kevin-nguyen-dev/stm32-dev-board-hw/stm32-dev-board-hw/models/SMLVT3V3.stp

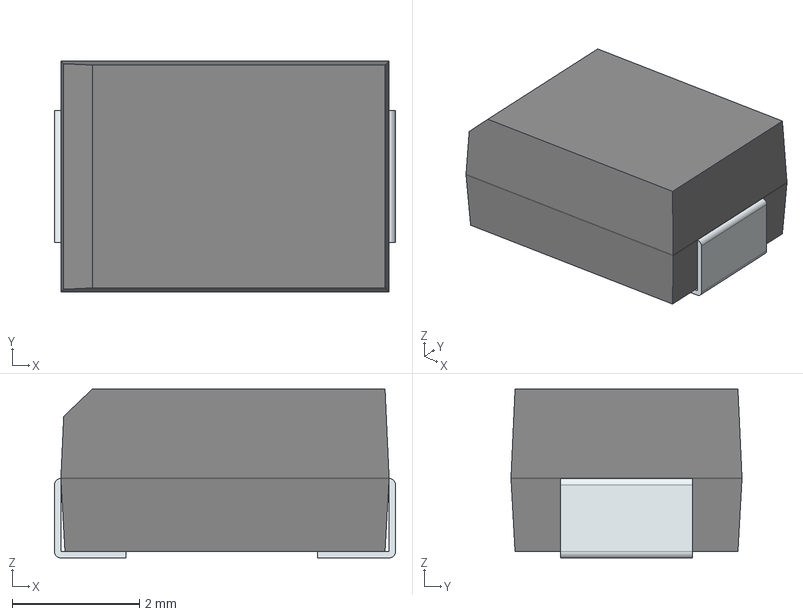
[picture p1: CAD file, 2024-08-15]
stm32-dev-board-hw/models/SMLVT3V3.stp
5.35 x 3.62 x 2.65 mm
FilletPin1
FilletPin2
