kevin-nguyen-dev/stm32-dev-board-hw/stm32-dev-board-hw/models/NX2016SA-32M-EXS00A-CS06465.stp

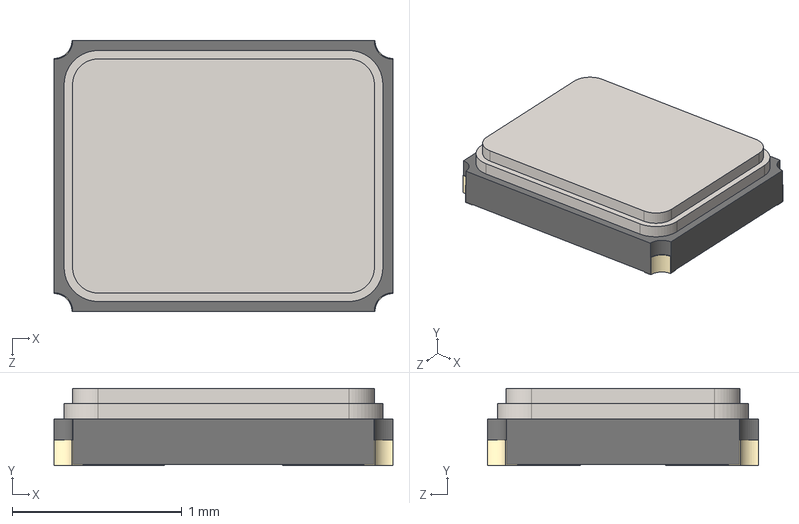
[picture p2: CAD file, 2024-08-15]
stm32-dev-board-hw/models/NX2016SA-32M-EXS00A-CS06465.stp
2.00 x 0.455 x 1.60 mm
