kevin-nguyen-dev/stm32-dev-board-hw/stm32-dev-board-hw/models/ANT1608LL14R2400A.stp

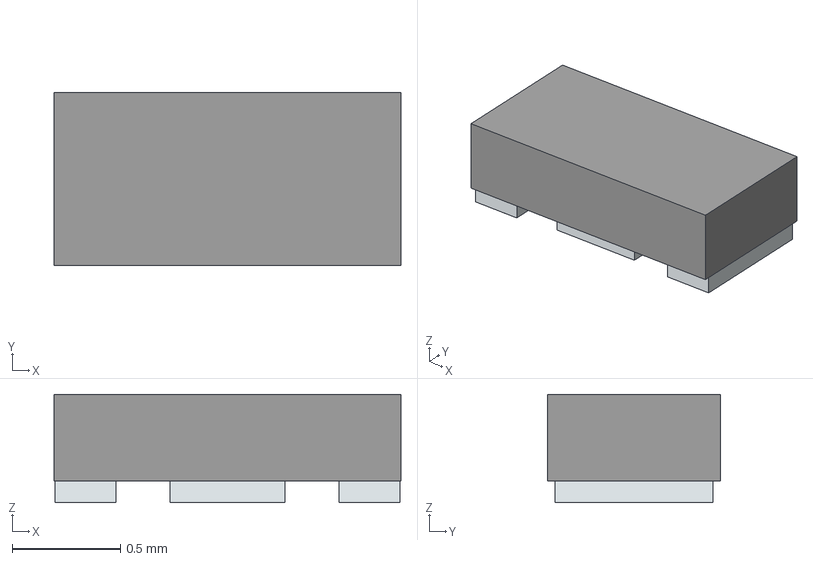
[picture p3: CAD file, 2024-08-15]
stm32-dev-board-hw/models/ANT1608LL14R2400A.stp
1.60 x 0.8 x 0.5 mm
Pins
