kevin-nguyen-dev/stm32-dev-board-hw/stm32-dev-board-hw/models/STM32WB55CEU6.stp

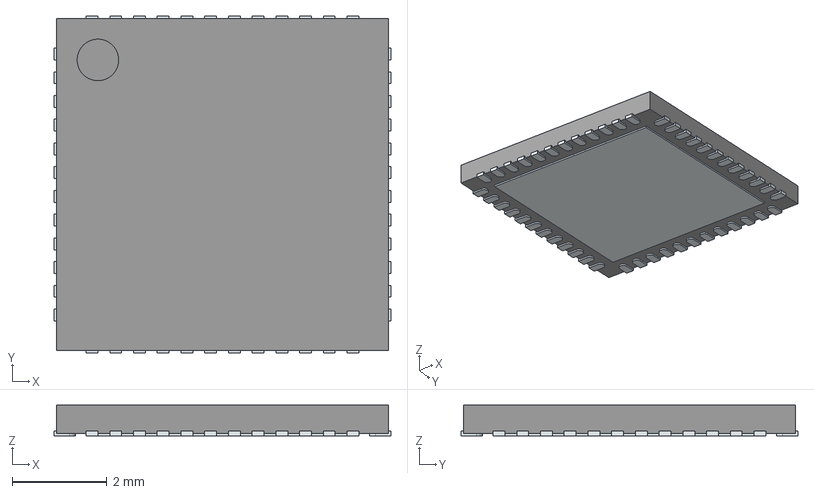
[picture p4: CAD file, 2024-08-15]
stm32-dev-board-hw/models/STM32WB55CEU6.stp
7.10 x 7.10 x 0.65 mm
ThermalPin
PinsArrayLR
PinsArrayTB
