kevin-nguyen-dev/stm32-dev-board-hw/stm32-dev-board-hw/models/DLF162500LT-5028A1.stp

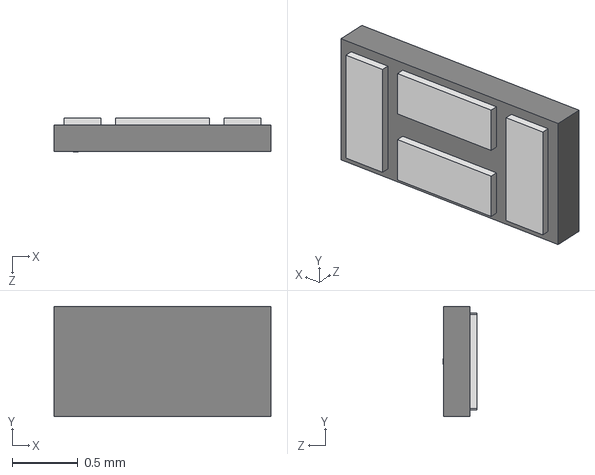
[picture p5: CAD file, 2024-08-15]
stm32-dev-board-hw/models/DLF162500LT-5028A1.stp
1.65 x 0.838 x 0.257 mm
