kevin-nguyen-dev/stm32-dev-board-hw/stm32-dev-board-hw/kicad-proj/stm32-dev-board/stm32-dev-board.kicad_pcb

## KiCad design stm32-dev-board-hw/kicad-proj/stm32-dev-board/stm32-dev-board.kicad_pcb (2024-08-15)

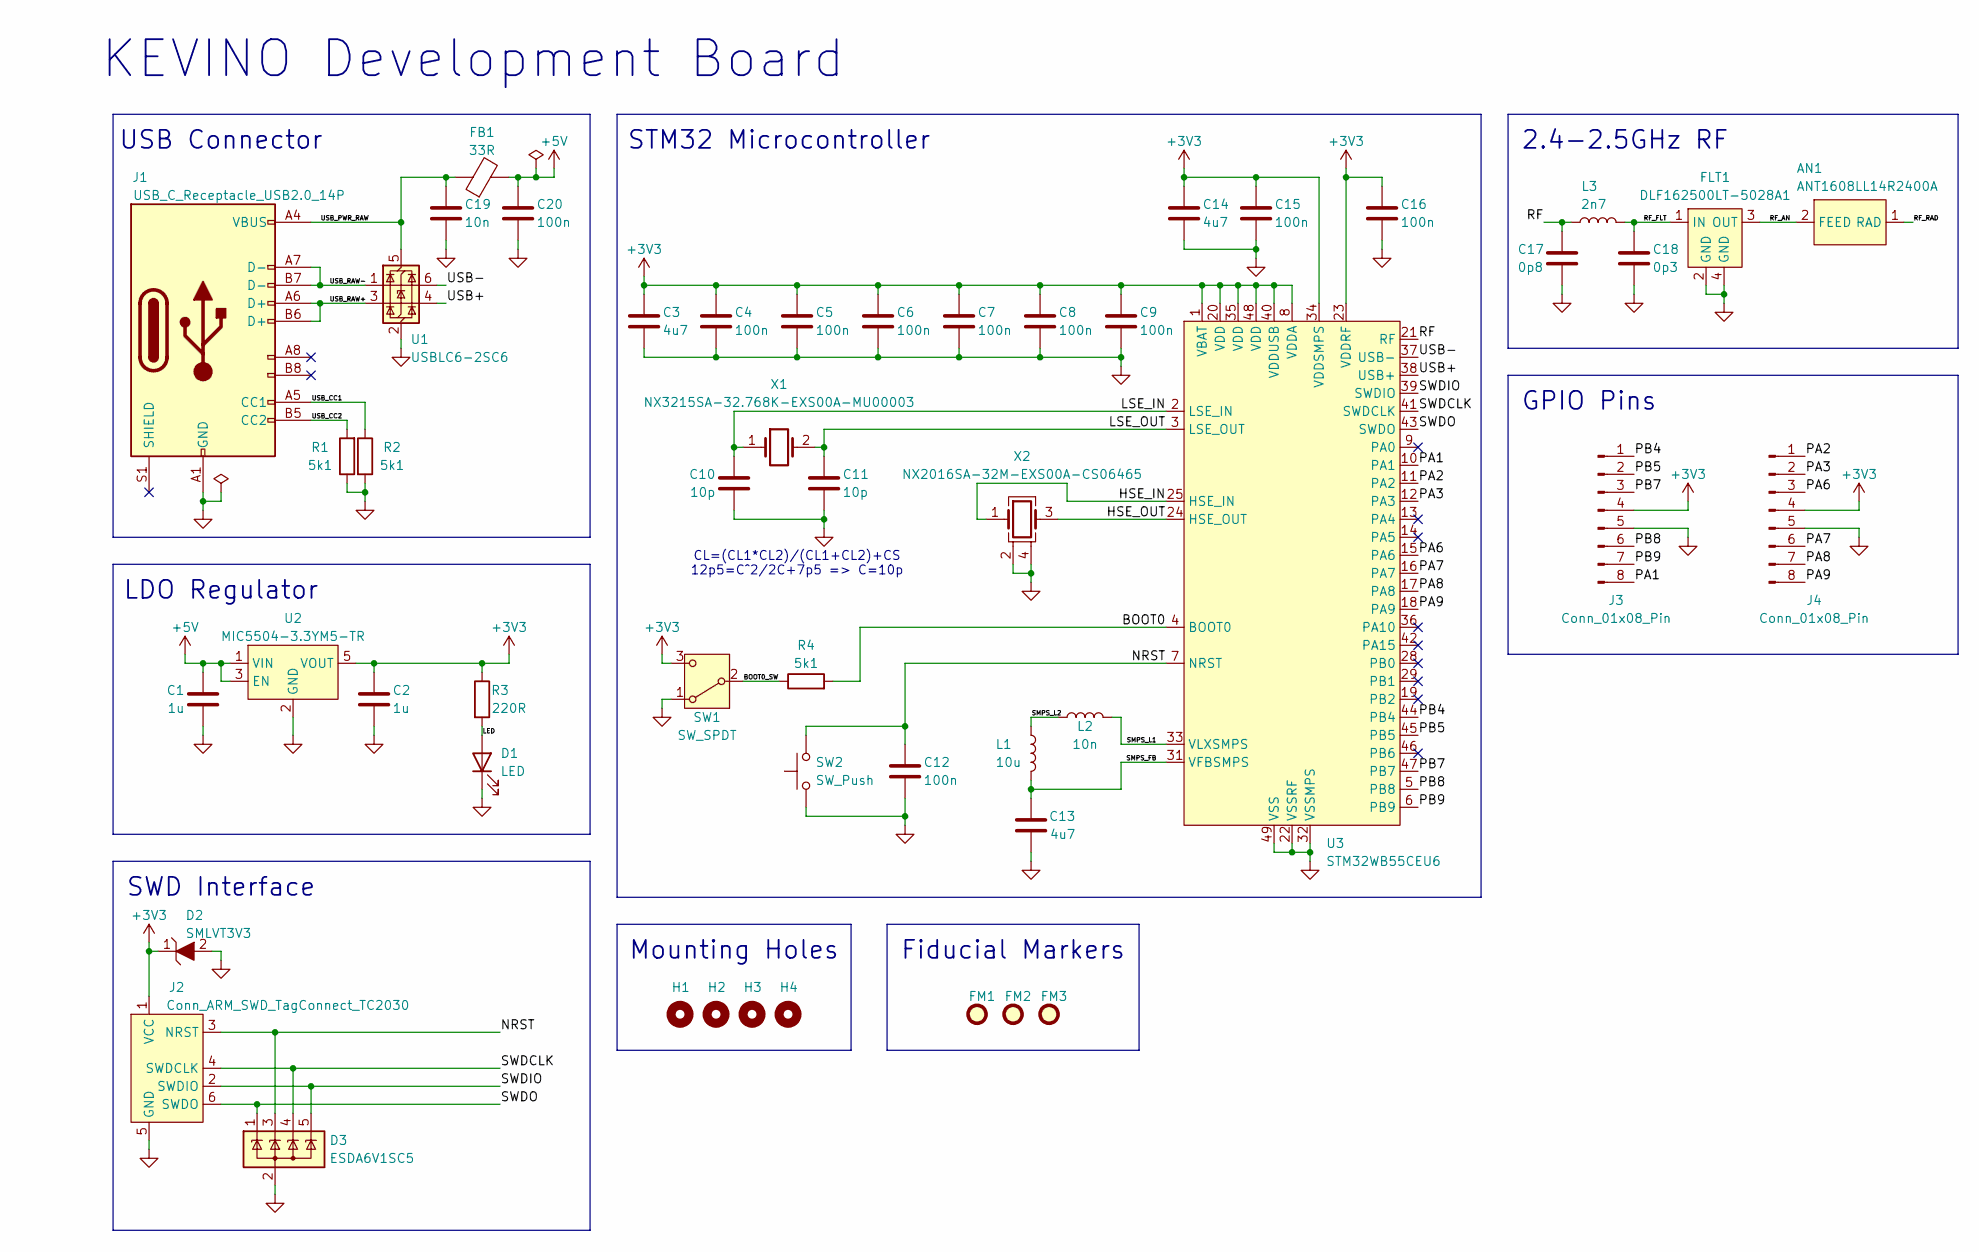
[picture p6: schematic stm32-dev-board.kicad_sch, KEVINO]

Parts:
AN1: ANT1608LL14R2400A; Manufacturer Part Number ANT1608LL14R2400A
C1, C2: 1u; C_0603_1608Metric; Manufacturer Part Number 0603ZD105KAT2A
C3, C13, C14: 4u7; C_0603_1608Metric; Manufacturer Part Number 0603YD475MAT2A
C4, C5, C6, C7, C8, C9, C12, C15, C16, C20: 100n; C_0402_1005Metric; Manufacturer Part Number 04023C104KAT2A
C10, C11: 10p; C_0402_1005Metric; Manufacturer Part Number 04025A100JAT2A
C17: 0p8; C_0402_1005Metric; Manufacturer Part Number GRM1555C1HR80BA01D
C18: 0p3; C_0402_1005Metric; Manufacturer Part Number GRM1555C1HR30WA01D
C19: 10n; C_0201_0603Metric; Manufacturer Part Number 0201ZC103JAT2A
D1: LED; LED_0402_1005Metric; Manufacturer Part Number 150040RS73240
D2: SMLVT3V3; Manufacturer Part Number SMLVT3V3
D3: ESDA6V1SC5; SOT-23-5; Manufacturer Part Number ESDA6V1SC5
FB1: 33R; R_0603_1608Metric; Manufacturer Part Number BLM18PG330SN1D
FLT1: DLF162500LT-5028A1; Manufacturer Part Number DLF162500LT-5028A1
FM1, FM2, FM3: Fiducial; Fiducial_1mm_Mask2mm
H1, H2, H3, H4: MountingHole; MountingHole_2.2mm_M2_DIN965_Pad
J1: USB_C_Receptacle_USB2.0_14P; USB_C_Receptacle_GCT_USB4105-xx-A_16P_TopMnt_Horizontal; Manufacturer Part Number USB4105-GF-A
J2: Conn_ARM_SWD_TagConnect_TC2030; Tag-Connect_TC2030-IDC-FP_2x03_P1.27mm_Vertical
J3, J4: Conn_01x08_Pin; PinHeader_1x08_P2.54mm_Vertical; Manufacturer Part Number 22-28-8082
L1: 10u; L_0805_2012Metric; Manufacturer Part Number LQM21FN100M70L
L2: 10n; L_0402_1005Metric; Manufacturer Part Number LQG15WZ10NJ02D
L3: 2n7; L_0402_1005Metric; Manufacturer Part Number LQG15HS2N7S02D
R1, R2, R4: 5k1; R_0402_1005Metric; Manufacturer Part Number RC0603FR-075K1L
R3: 220R; R_0402_1005Metric; Manufacturer Part Number RC0402FR-07221RL
SW1: SW_SPDT; SW_SPDT_PCM12; Manufacturer Part Number PCM12SMTR
SW2: SW_Push; SW_SPST_CK_RS282G05A3; Manufacturer Part Number RS282G05A3SMRT
U1: USBLC6-2SC6; SOT-23-6; Manufacturer Part Number USBLC6-2SC6
U2: MIC5504-3.3YM5-TR; SOT-23-5; Manufacturer Part Number MIC5504-3.3YM5-TR
U3: STM32WB55CEU6; Manufacturer Part Number STM32WB55CEU6
X1: NX3215SA-32.768K-EXS00A-MU00003; Crystal_SMD_MicroCrystal_CC7V-T1A-2Pin_3.2x1.5mm; Manufacturer Part Number NX3215SA-32.768K-EXS00A-MU00003
X2: NX2016SA-32M-EXS00A-CS06465; Crystal_SMD_2016-4Pin_2.0x1.6mm; Manufacturer Part Number NX2016SA-32M-EXS00A-CS06465

Connections:
+3V3: C2.1, C3.1, C4.1, C5.1, C6.1, C7.1, C8.1, C9.1, C14.1, C15.1, C16.1, D2.1, J2.1 (VCC), J3.4, J4.4, R3.1, SW1.3 (C), U2.5 (VOUT), U3.1 (VBAT), U3.8 (VDDA), U3.20 (VDD), U3.23 (VDDRF), U3.34 (VDDSMPS), U3.35 (VDD), U3.40 (VDDUSB), U3.48 (VDD)
+5V: C1.2, C20.1, FB1.2, U2.1 (VIN), U2.3 (EN)
/BOOT0: R4.2, U3.4 (BOOT0)
/BOOT0_SW: R4.1, SW1.2 (B)
/HSE_IN: U3.25 (HSE_IN), X2.1
/HSE_OUT: U3.24 (HSE_OUT), X2.3
/LED: D1.2 (A), R3.2
/LSE_IN: C10.2, U3.2 (LSE_IN), X1.1
/LSE_OUT: C11.1, U3.3 (LSE_OUT), X1.2
/NRST: C12.1, D3.3 (K), J2.3 (NRST), SW2.2, U3.7 (NRST)
/PA1: J3.8, U3.10 (PA1)
/PA2: J4.1, U3.11 (PA2)
/PA3: J4.2, U3.12 (PA3)
/PA6: J4.3, U3.15 (PA6)
/PA7: J4.6, U3.16 (PA7)
/PA8: J4.7, U3.17 (PA8)
/PA9: J4.8, U3.18 (PA9)
/PB4: J3.1, U3.44 (PB4)
/PB5: J3.2, U3.45 (PB5)
/PB7: J3.3, U3.47 (PB7)
/PB8: J3.6, U3.5 (PB8)
/PB9: J3.7, U3.6 (PB9)
/RF: C17.2, L3.1, U3.21 (RF)
/RF_AN: AN1.2 (FEED), FLT1.3 (OUT)
/RF_FLT: C18.1, FLT1.1 (IN), L3.2
/RF_RAD: AN1.1 (RAD)
/SMPS_FB: C13.2, L1.2, U3.31 (VFBSMPS)
/SMPS_L1: L2.2, U3.33 (VLXSMPS)
/SMPS_L2: L1.1, L2.1
/SWDCLK: D3.4 (K), J2.4 (SWDCLK), U3.41 (SWDCLK)
/SWDIO: D3.5 (K), J2.2 (SWDIO), U3.39 (SWDIO)
/SWDO: D3.1 (K), J2.6 (SWDO), U3.43 (SWDO)
/USB+: U1.4 (I/O2), U3.38 (USB+)
/USB-: U1.6 (I/O1), U3.37 (USB-)
/USB_CC1: J1.A5 (CC1), R2.1
/USB_CC2: J1.B5 (CC2), R1.2
/USB_PWR_RAW: C19.1, FB1.1, J1.A4 (VBUS), J1.A9 (VBUS), J1.B4 (VBUS), J1.B9 (VBUS), U1.5 (VBUS)
/USB_RAW+: J1.A6 (D+), J1.B6 (D+), U1.3 (I/O2)
/USB_RAW-: J1.A7 (D-), J1.B7 (D-), U1.1 (I/O1)
GND: C1.1, C2.2, C3.2, C4.2, C5.2, C6.2, C7.2, C8.2, C9.2, C10.1, C11.2, C12.2, C13.1, C14.2, C15.2, C16.2, C17.1, C18.2, C19.2, C20.2, D1.1 (K), D2.2, D3.2 (A), FLT1.2 (GND), FLT1.4 (GND), J1.A1 (GND), J1.A12 (GND), J1.B1 (GND), J1.B12 (GND), J2.5 (GND), J3.5, J4.5, R1.1, R2.2, SW1.1 (A), SW2.1, U1.2 (GND), U2.2 (GND), U3.22 (VSSRF), U3.32 (VSSMPS), U3.49 (VSS), X2.2, X2.4

Notes on the sheet:
KEVINO Development Board
2.4-2.5GHz RF
USB Connector
GPIO Pins
LDO Regulator
CL=(CL1*CL2)/(CL1+CL2)+CS 12p5=C^2/2C+7p5 => C=10p
Fiducial Markers
SWD Interface
STM32 Microcontroller
Mounting Holes

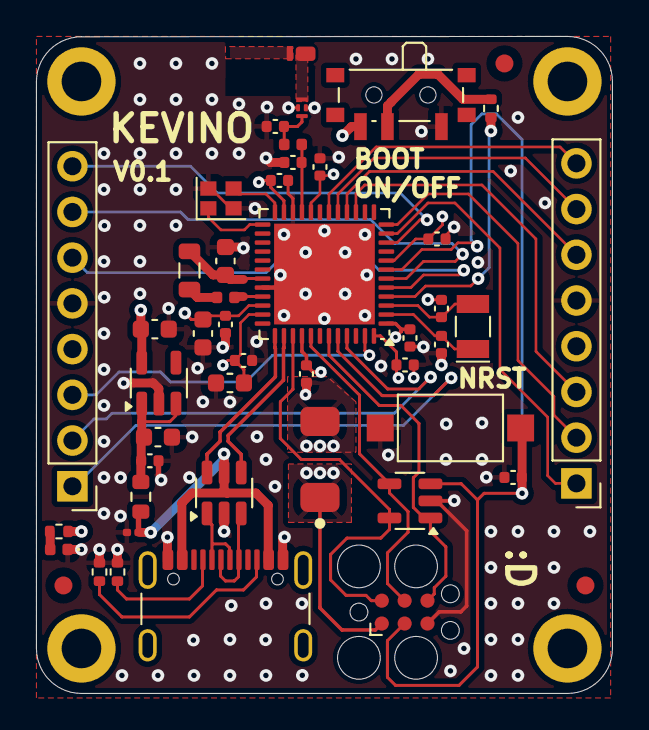
[picture p7: board stm32-dev-board.kicad_pcb from above]

Board: 4 copper layers, 32.0 x 36.5 mm, 51 parts (0 on the bottom side), 39 nets.
